romapres2010/ventilation/img/automatic/automatic5.jpeg

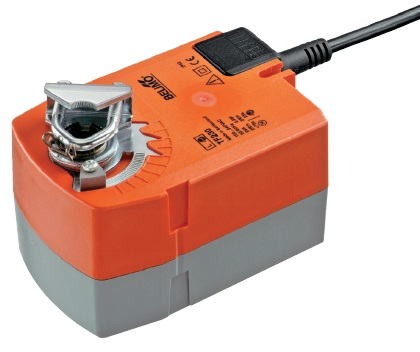
img/automatic/automatic5.jpeg
