romapres2010/ventilation/img/balcony/balcony2.jpeg

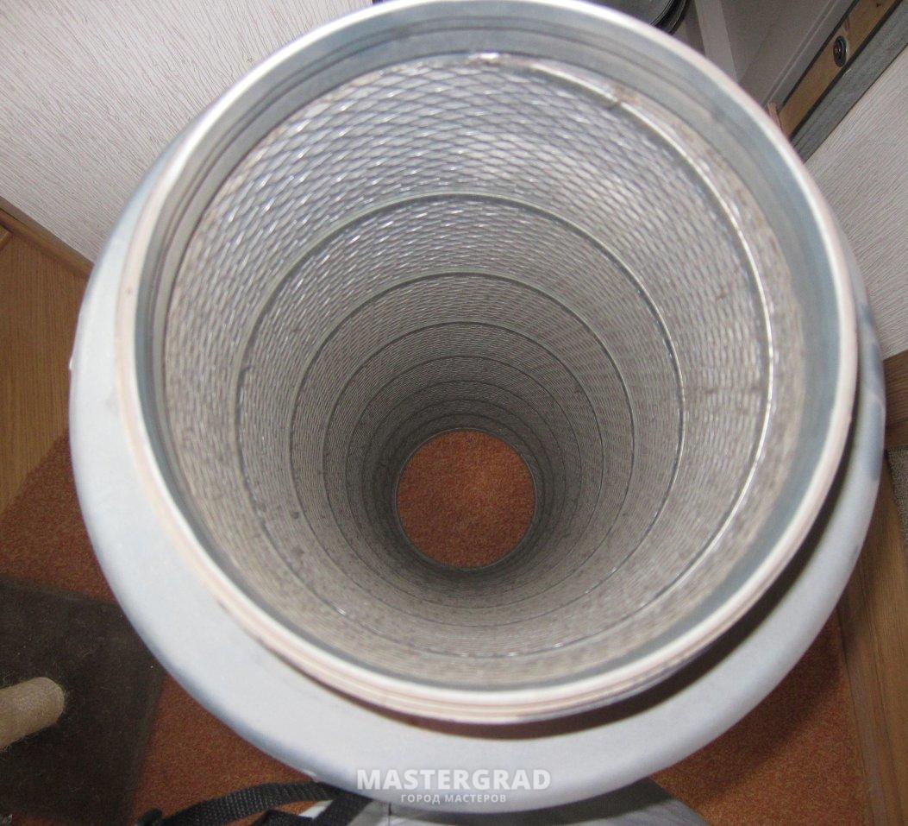
img/balcony/balcony2.jpeg
