romapres2010/ventilation/img/balcony/balcony3.jpeg

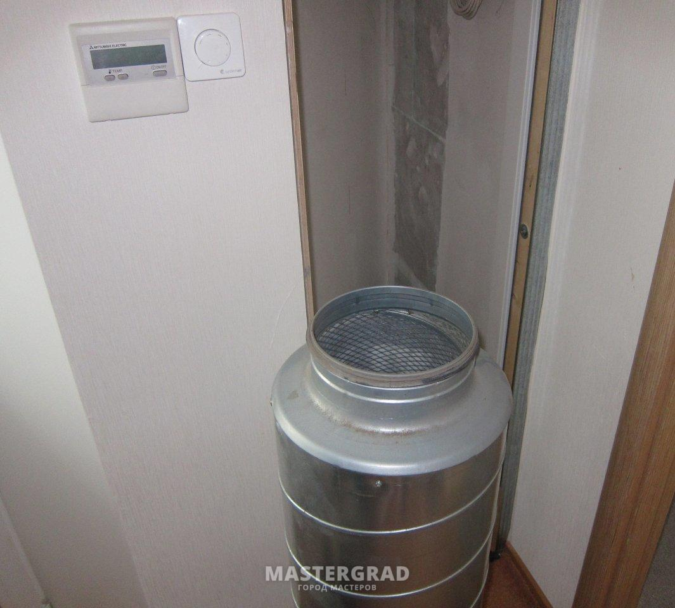
img/balcony/balcony3.jpeg
