romapres2010/ventilation/img/electro/electro1.jpeg

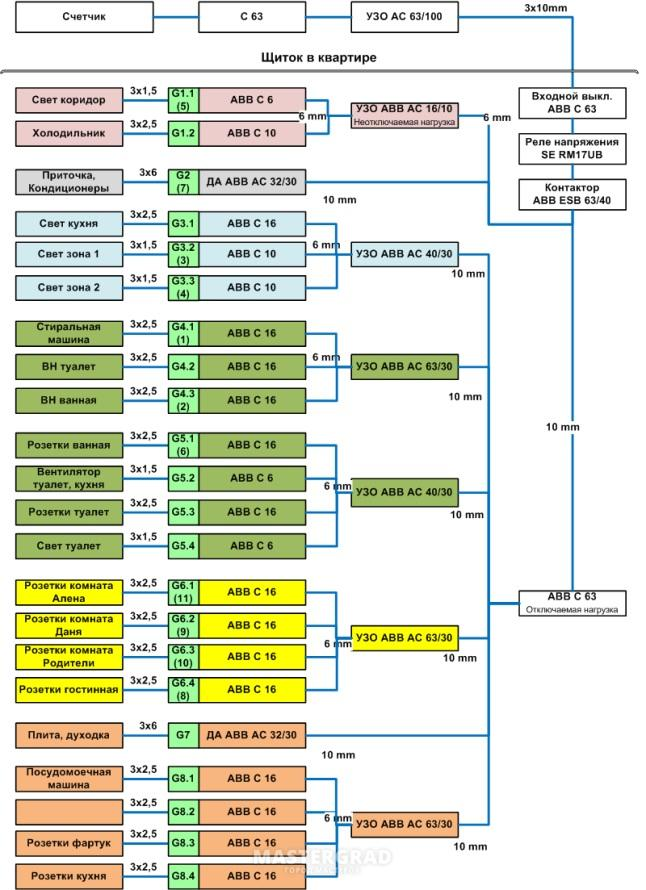
img/electro/electro1.jpeg
