romapres2010/ventilation/img/electro/electro2.jpeg

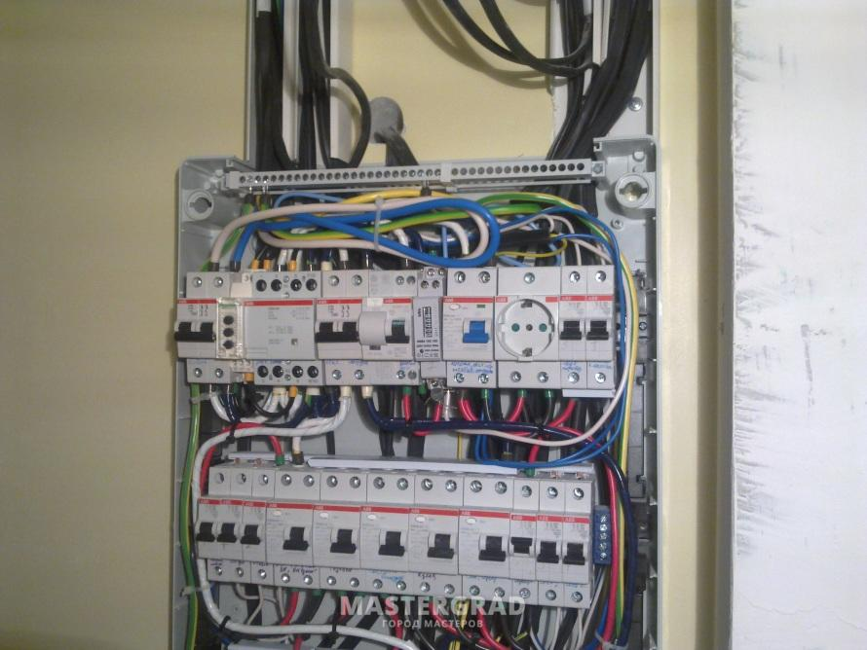
img/electro/electro2.jpeg
