romapres2010/ventilation/img/electro/electro3.jpeg

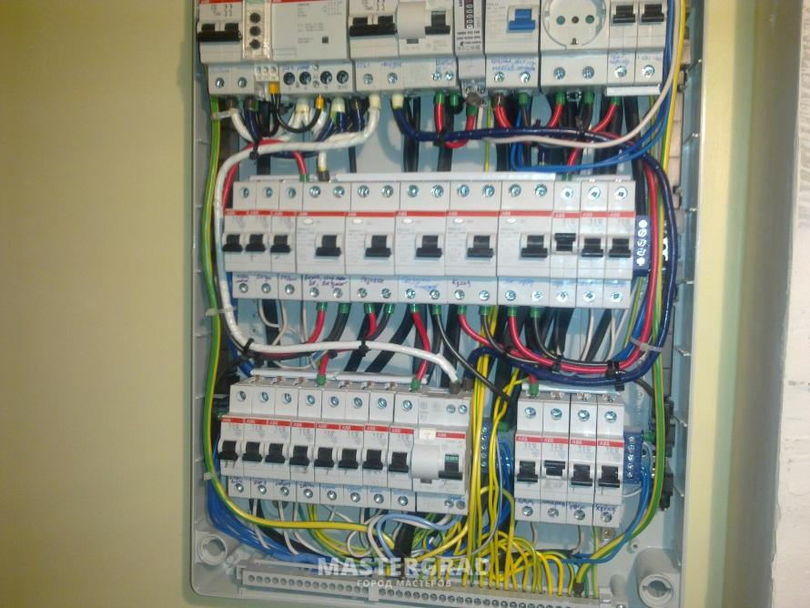
img/electro/electro3.jpeg
