romapres2010/ventilation/img/electro/electro4.jpeg

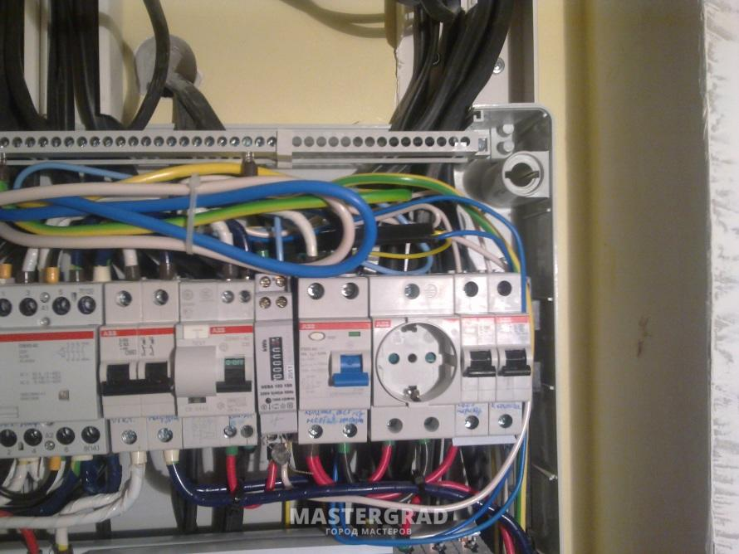
img/electro/electro4.jpeg
