romapres2010/ventilation/img/electro/electro5.jpeg

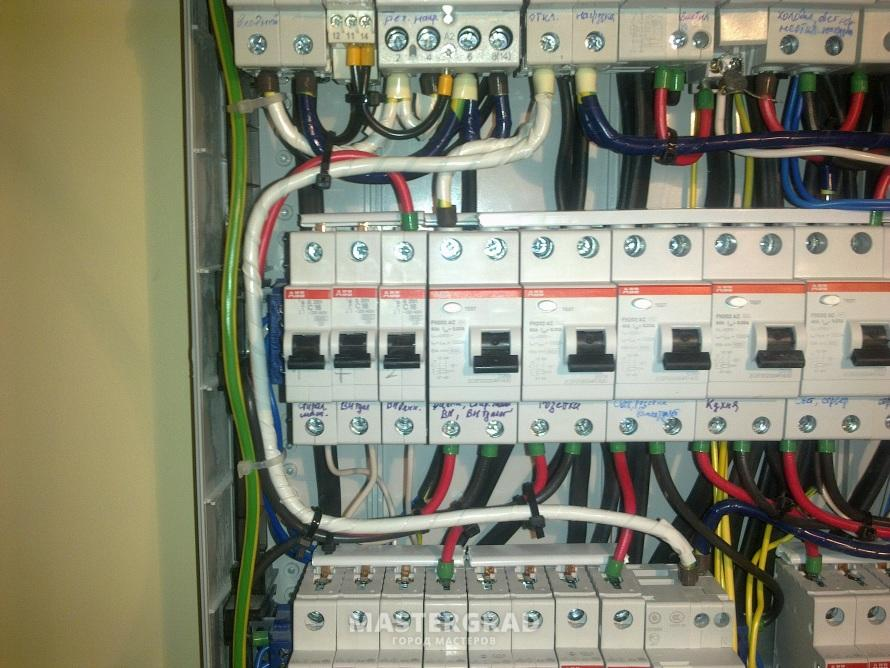
img/electro/electro5.jpeg
