romapres2010/ventilation/img/electro/electro6.jpeg

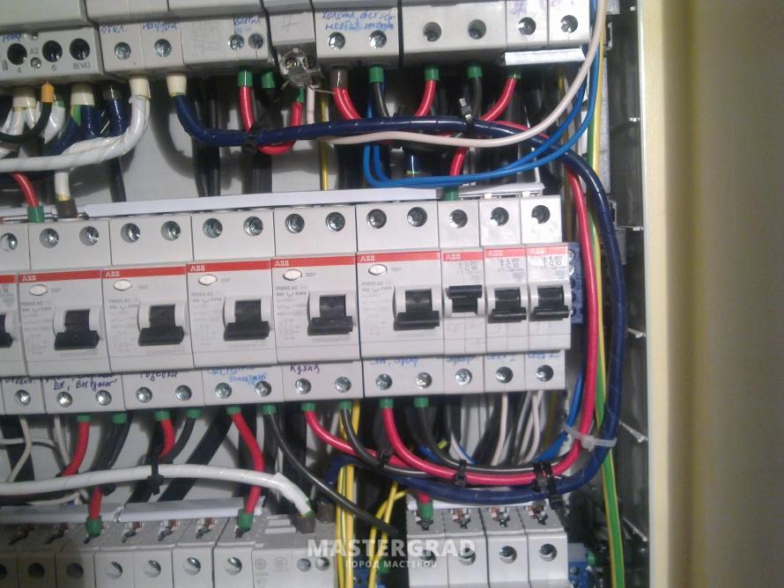
img/electro/electro6.jpeg
