romapres2010/ventilation/img/electro/electro7.jpeg

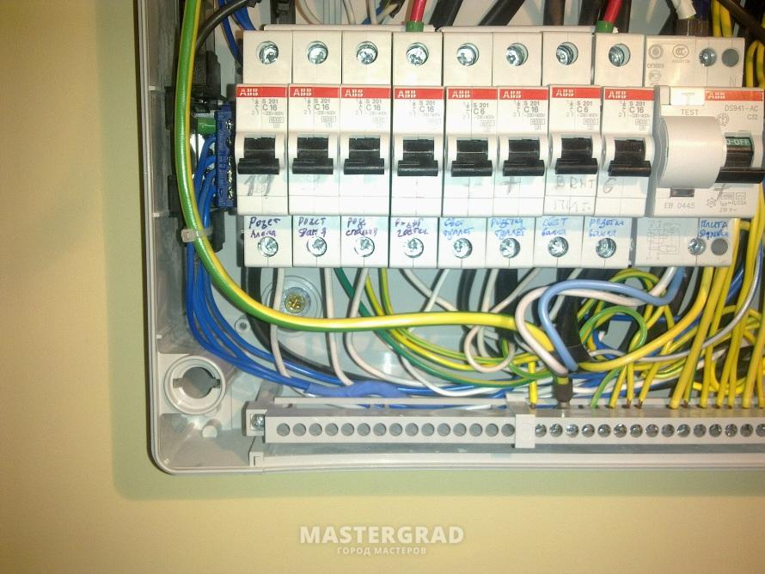
img/electro/electro7.jpeg
