romapres2010/ventilation/img/electro/electro8.jpeg

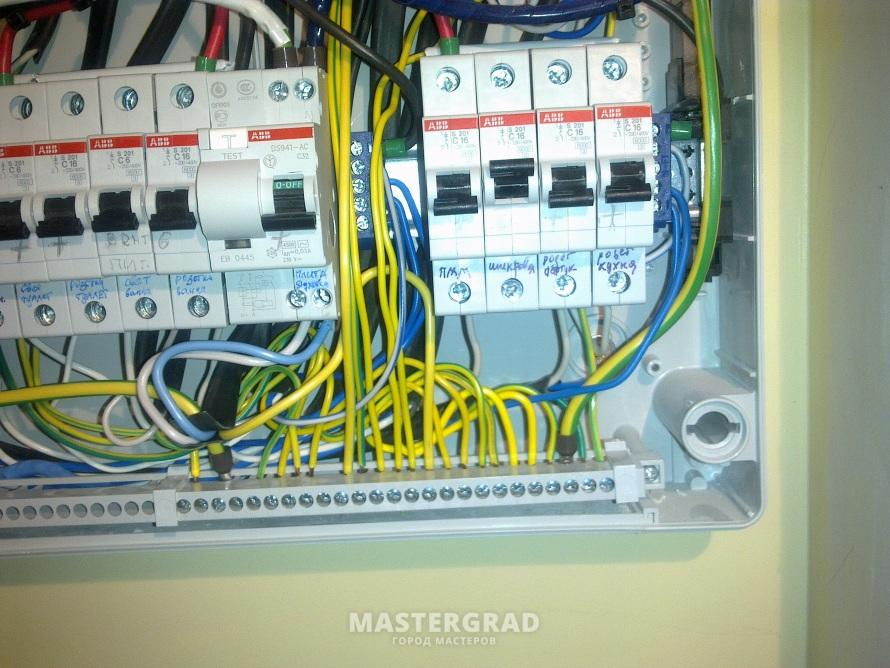
img/electro/electro8.jpeg
