romapres2010/ventilation/img/filter/filter2.jpeg

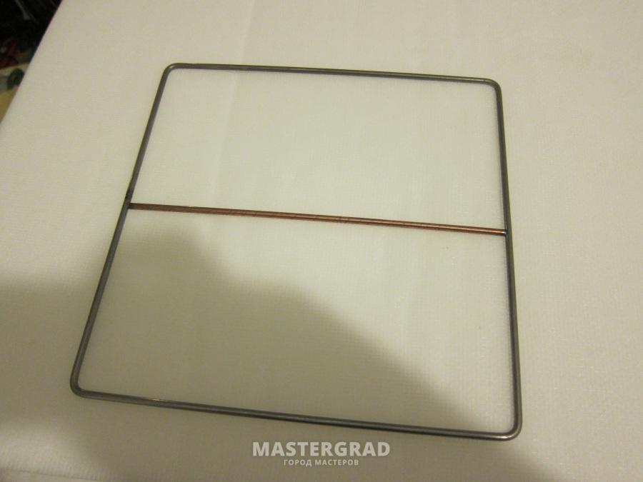
img/filter/filter2.jpeg
