romapres2010/ventilation/img/full_plan2.png

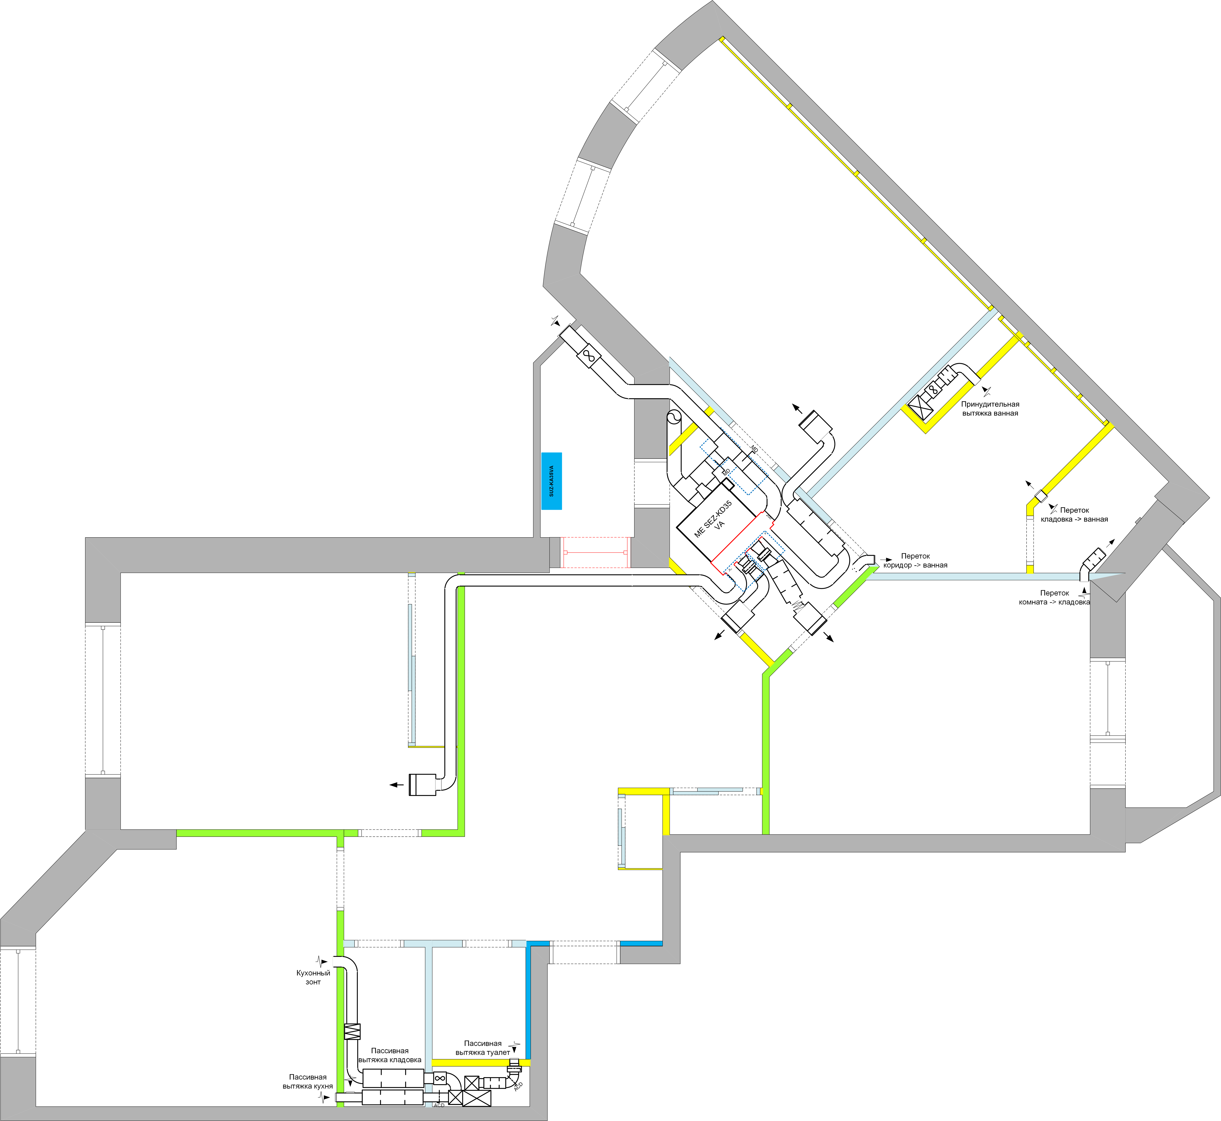
img/full_plan2.png
