romapres2010/ventilation/img/grilles/grilles3.png

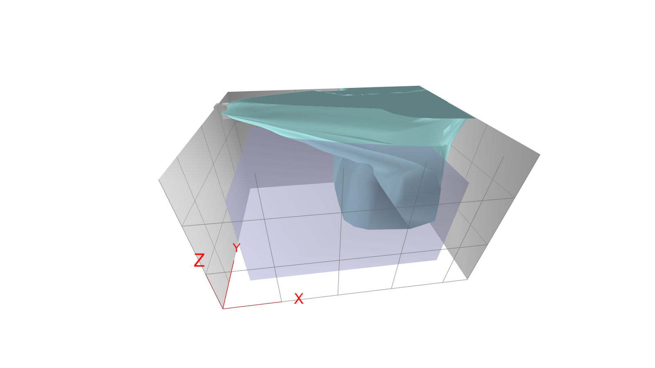
img/grilles/grilles3.png
