romapres2010/ventilation/img/heater/heater5.jpeg

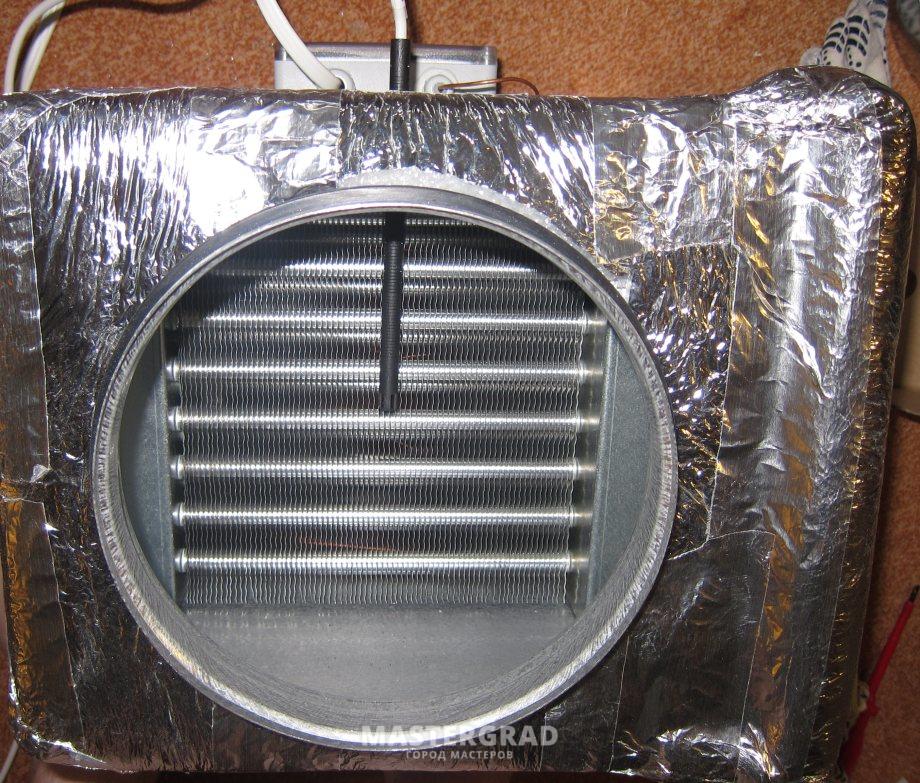
img/heater/heater5.jpeg
