romapres2010/ventilation/img/heater/heater10.jpeg

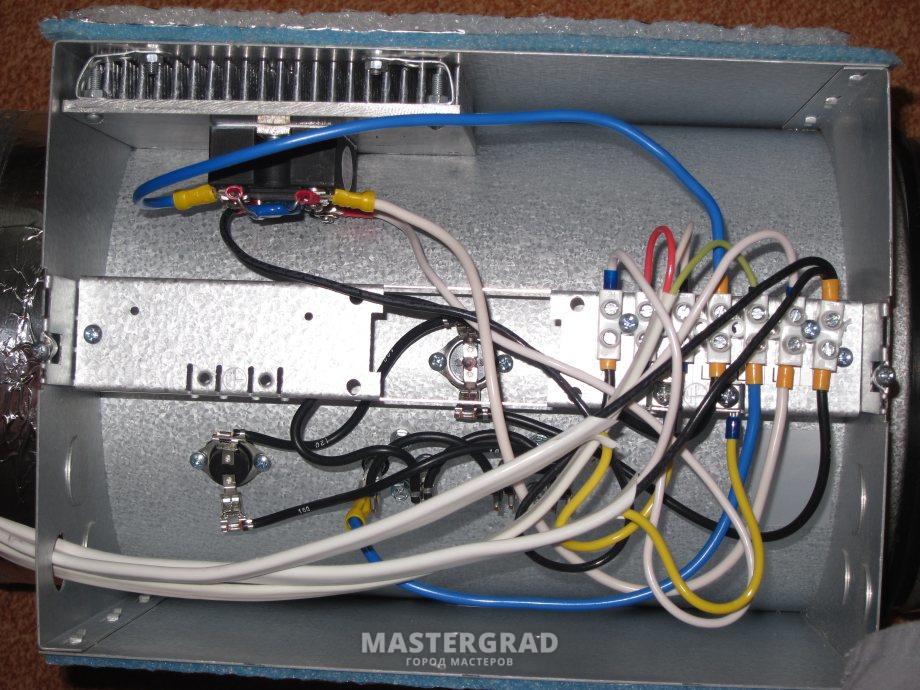
img/heater/heater10.jpeg
