romapres2010/ventilation/img/kitchen/kitchen7.jpeg

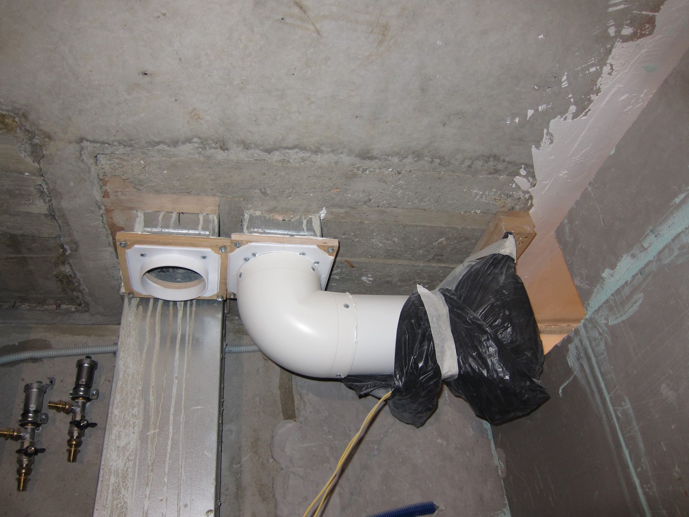
img/kitchen/kitchen7.jpeg
