romapres2010/ventilation/img/plenum_box/plenum_box5.jpeg

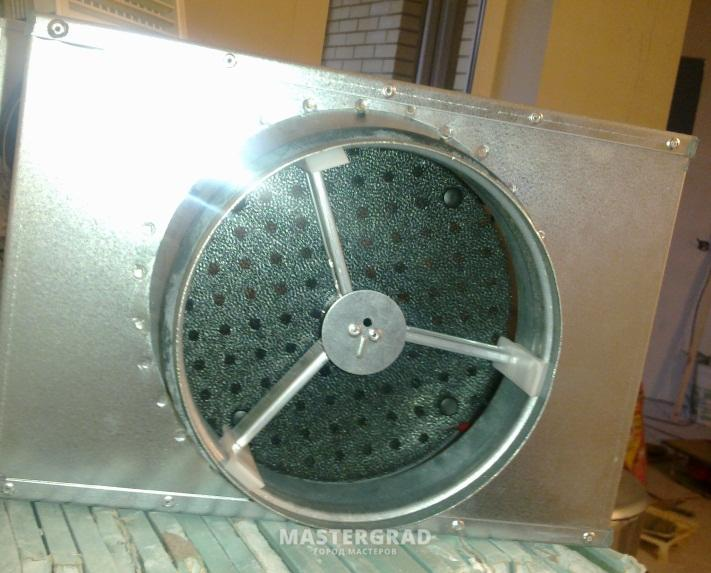
img/plenum_box/plenum_box5.jpeg
