romapres2010/ventilation/img/water/water9.png

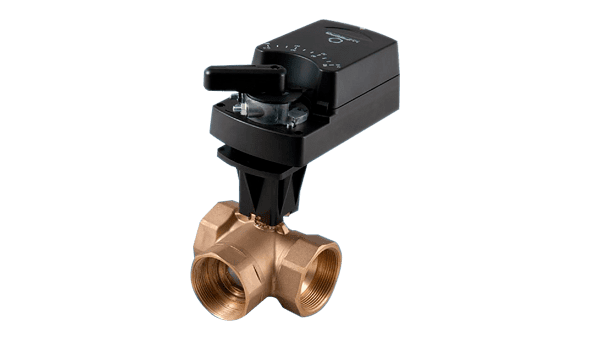
img/water/water9.png
