romapres2010/ventilation/img/water/water10.jpeg

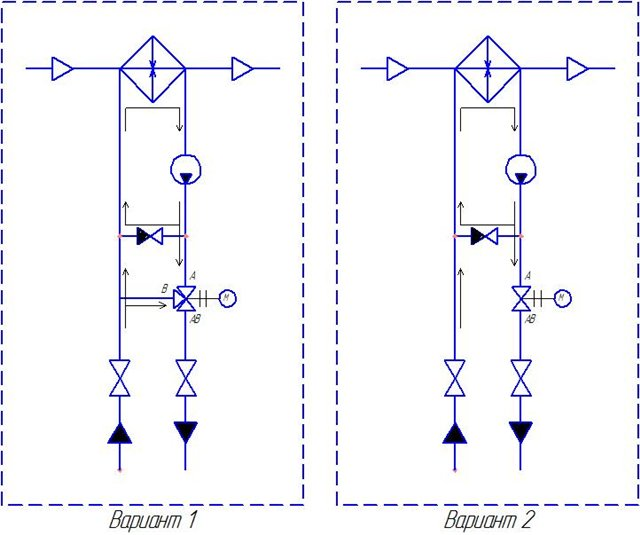
img/water/water10.jpeg
