romapres2010/ventilation/img/клапан1.jpg

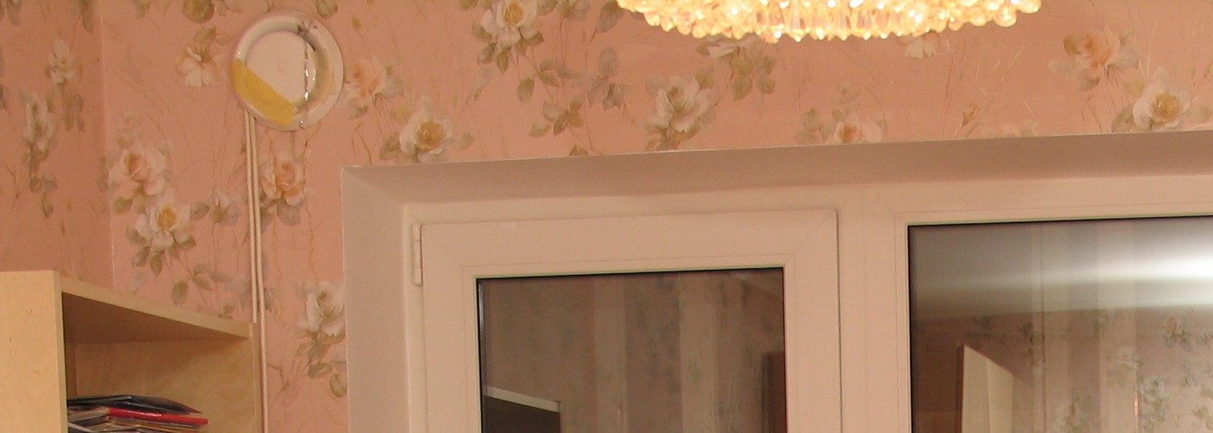
img/клапан1.jpg
