romapres2010/ventilation/doc/911-m-scheme-main.pdf

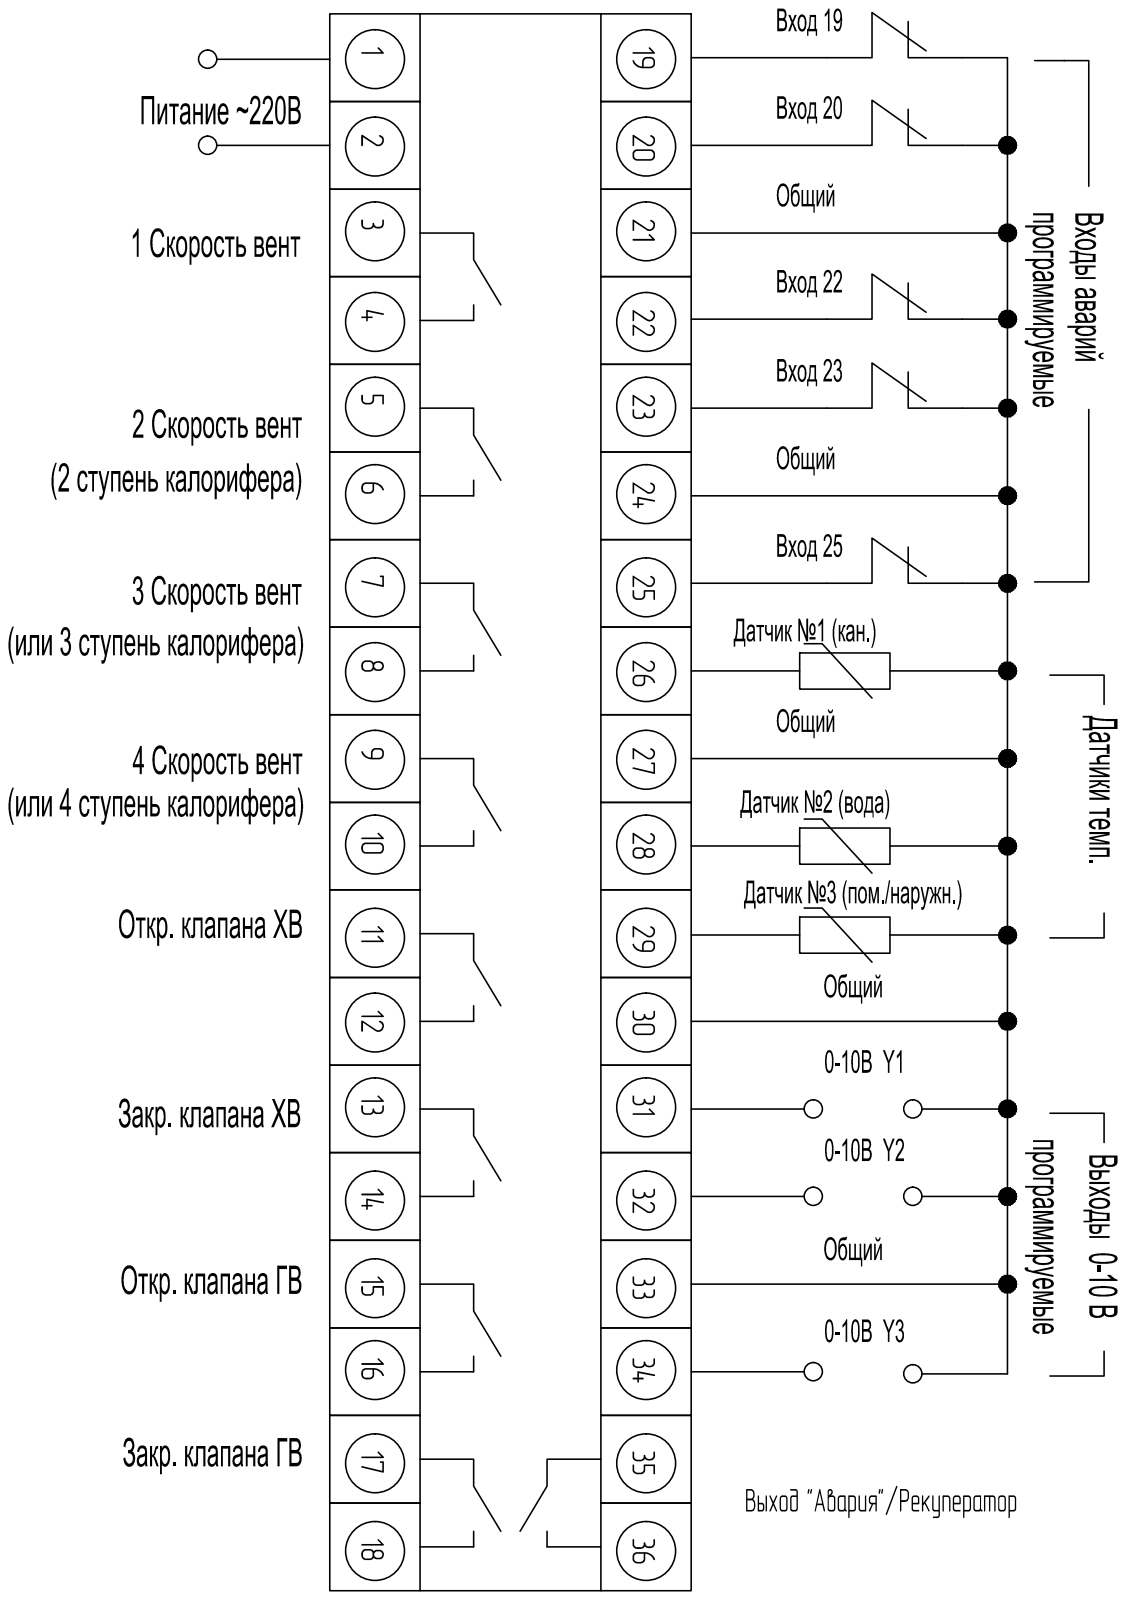
[picture p107: page 1]
