romapres2010/ventilation/(list of files, drawings)

Other design files:
doc/splan70/Layouts/elements.spl7
doc/splan70/Layouts/Parent-Child.spl7
doc/splan70/Templates/A4_Landscape_1.spl7
doc/splan70/Templates/A4_Landscape_2.spl7
doc/splan70/Templates/A4_Landscape_3.spl7
doc/splan70/Templates/A4_Landscape_4.spl7
doc/splan70/Templates/A4_Portrait_1.spl7
doc/splan70/Templates/A4_Portrait_2.spl7
doc/Схема приточной вентиляции v1.18.spl7
doc/Схема приточной вентиляции v2.2.spl7
